MissouriMRDT/UV-Vis_Spectrometer_Hardware/UV-Vis_Spectrometer_LED_Breakout/Models/8060-2C-Step.step

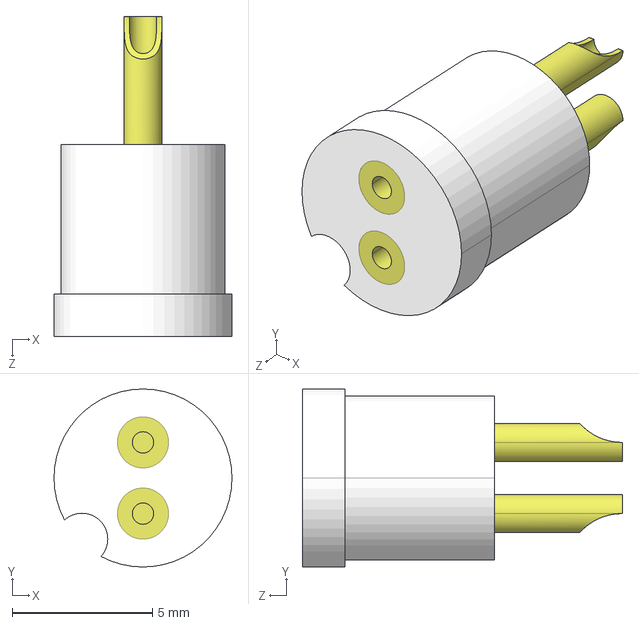
[picture p1: CAD file, 2026-11-08]
UV-Vis_Spectrometer_LED_Breakout/Models/8060-2C-Step.step
6.35 x 6.35 x 11.4 mm
