MissouriMRDT/UV-Vis_Spectrometer_Hardware/UV-Vis_Spectrometer_Photodiode_Breakout/3D Models/9007-05-00.stp

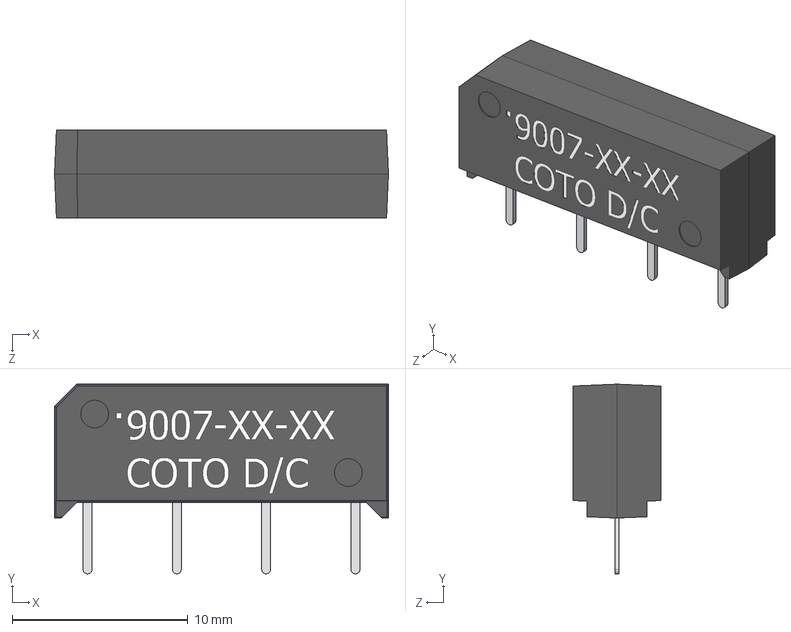
[picture p2: CAD file, 2026-11-07]
UV-Vis_Spectrometer_Photodiode_Breakout/3D Models/9007-05-00.stp
19.0 x 10.8 x 5.03 mm
