MissouriMRDT/UV-Vis_Spectrometer_Hardware/UV-Vis_Spectrometer_Photodiode_Breakout/UV-Vis_Spectrometer_Photodiode_Breakout.step

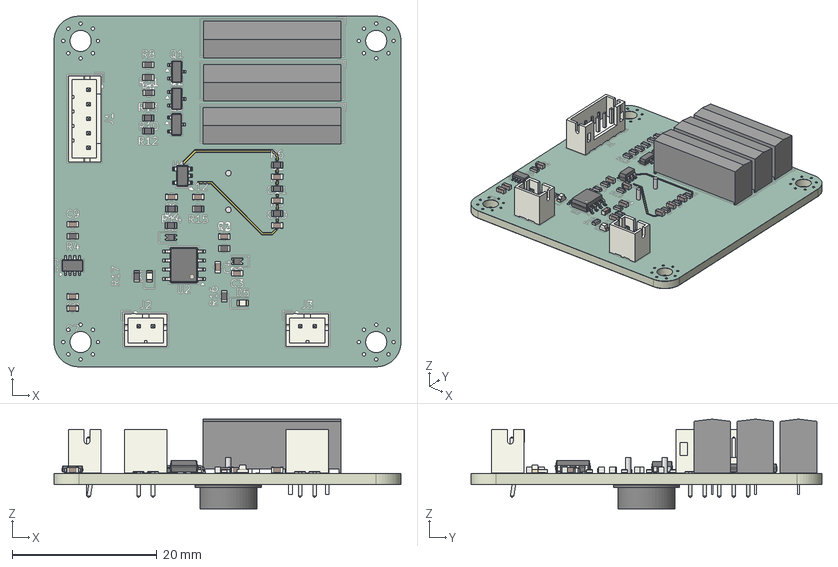
[picture p3: CAD file, 2026-11-03]
UV-Vis_Spectrometer_Photodiode_Breakout/UV-Vis_Spectrometer_Photodiode_Breakout.step
48.0 x 48.5 x 12.4 mm
D_0603 x 2
R_0603_1608Metric x 16
C_0603_1608Metric x 11
TSOT-23-8
JST_B2B_PH_K x 2
SOT-23 x 3
LED_0603_1608Metric x 2
SOT-23-5
HE3621A0510 x 3
SOIC-8_3.9x4.9mm_P1.27mm
JST_B5B_PH_K
UV-4BB8_copper
UV-4BB8_silkscreen x 2
UV-4BB8_soldermask x 2
UV-4BB8_PCB
