MissouriMRDT/UV-Vis_Spectrometer_Hardware/UV-Vis_Spectrometer_LED_Breakout/Models/LED590L-Step.step

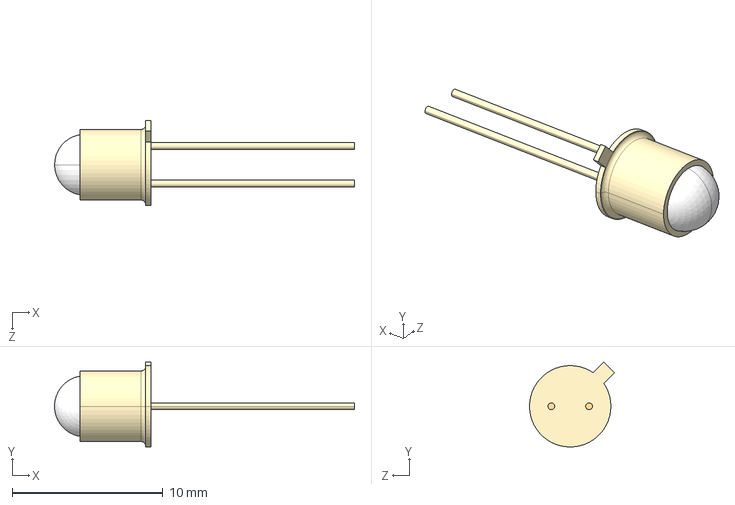
[picture p4: CAD file, 2026-11-08]
UV-Vis_Spectrometer_LED_Breakout/Models/LED590L-Step.step
19.9 x 5.64 x 5.64 mm
