MissouriMRDT/UV-Vis_Spectrometer_Hardware/UV-Vis_Spectrometer_Photodiode_Breakout/3D Models/HE3621A0510.stp

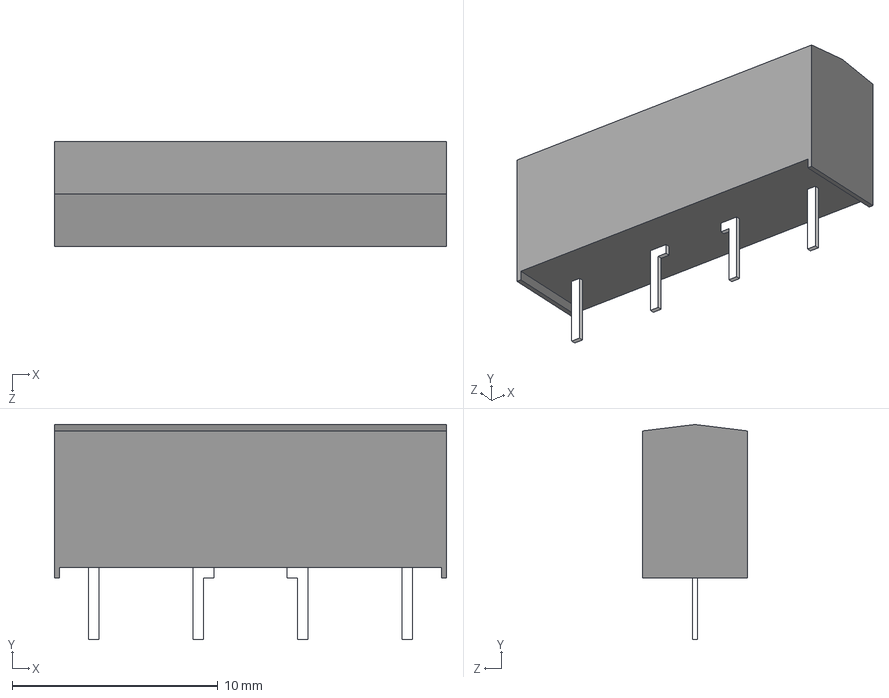
[picture p5: CAD file, 2026-11-03]
UV-Vis_Spectrometer_Photodiode_Breakout/3D Models/HE3621A0510.stp
19.1 x 10.5 x 5.08 mm
