MissouriMRDT/UV-Vis_Spectrometer_Hardware/UV-Vis_Spectrometer_Photodiode_Breakout/3D Models/TO99_BPW20RF_VIS.step

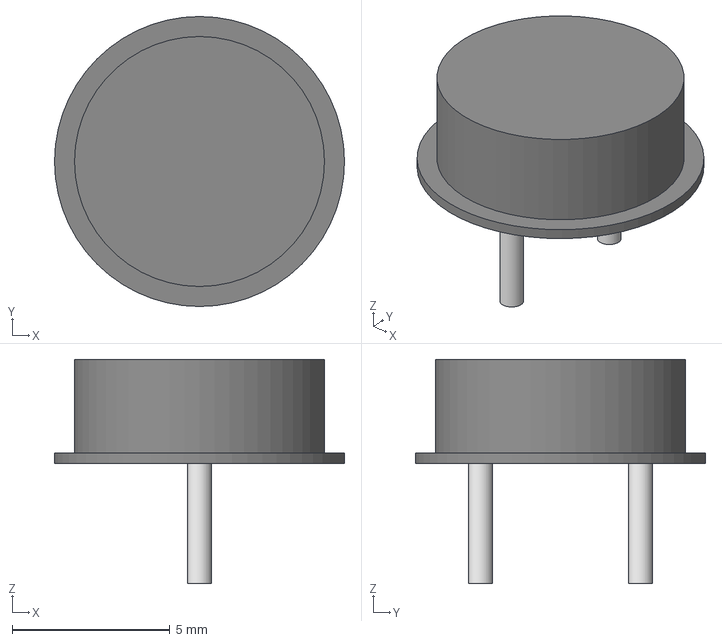
[picture p6: CAD file, 2026-11-03]
UV-Vis_Spectrometer_Photodiode_Breakout/3D Models/TO99_BPW20RF_VIS.step
9.19 x 9.19 x 7.11 mm
