MissouriMRDT/UV-Vis_Spectrometer_Hardware/UV-Vis_Spectrometer_Photodiode_Breakout/UV-Vis_Spectrometer_Photodiode_Breakout.kicad_pcb

## KiCad design UV-Vis_Spectrometer_Photodiode_Breakout/UV-Vis_Spectrometer_Photodiode_Breakout.kicad_pcb (2026-11-14)

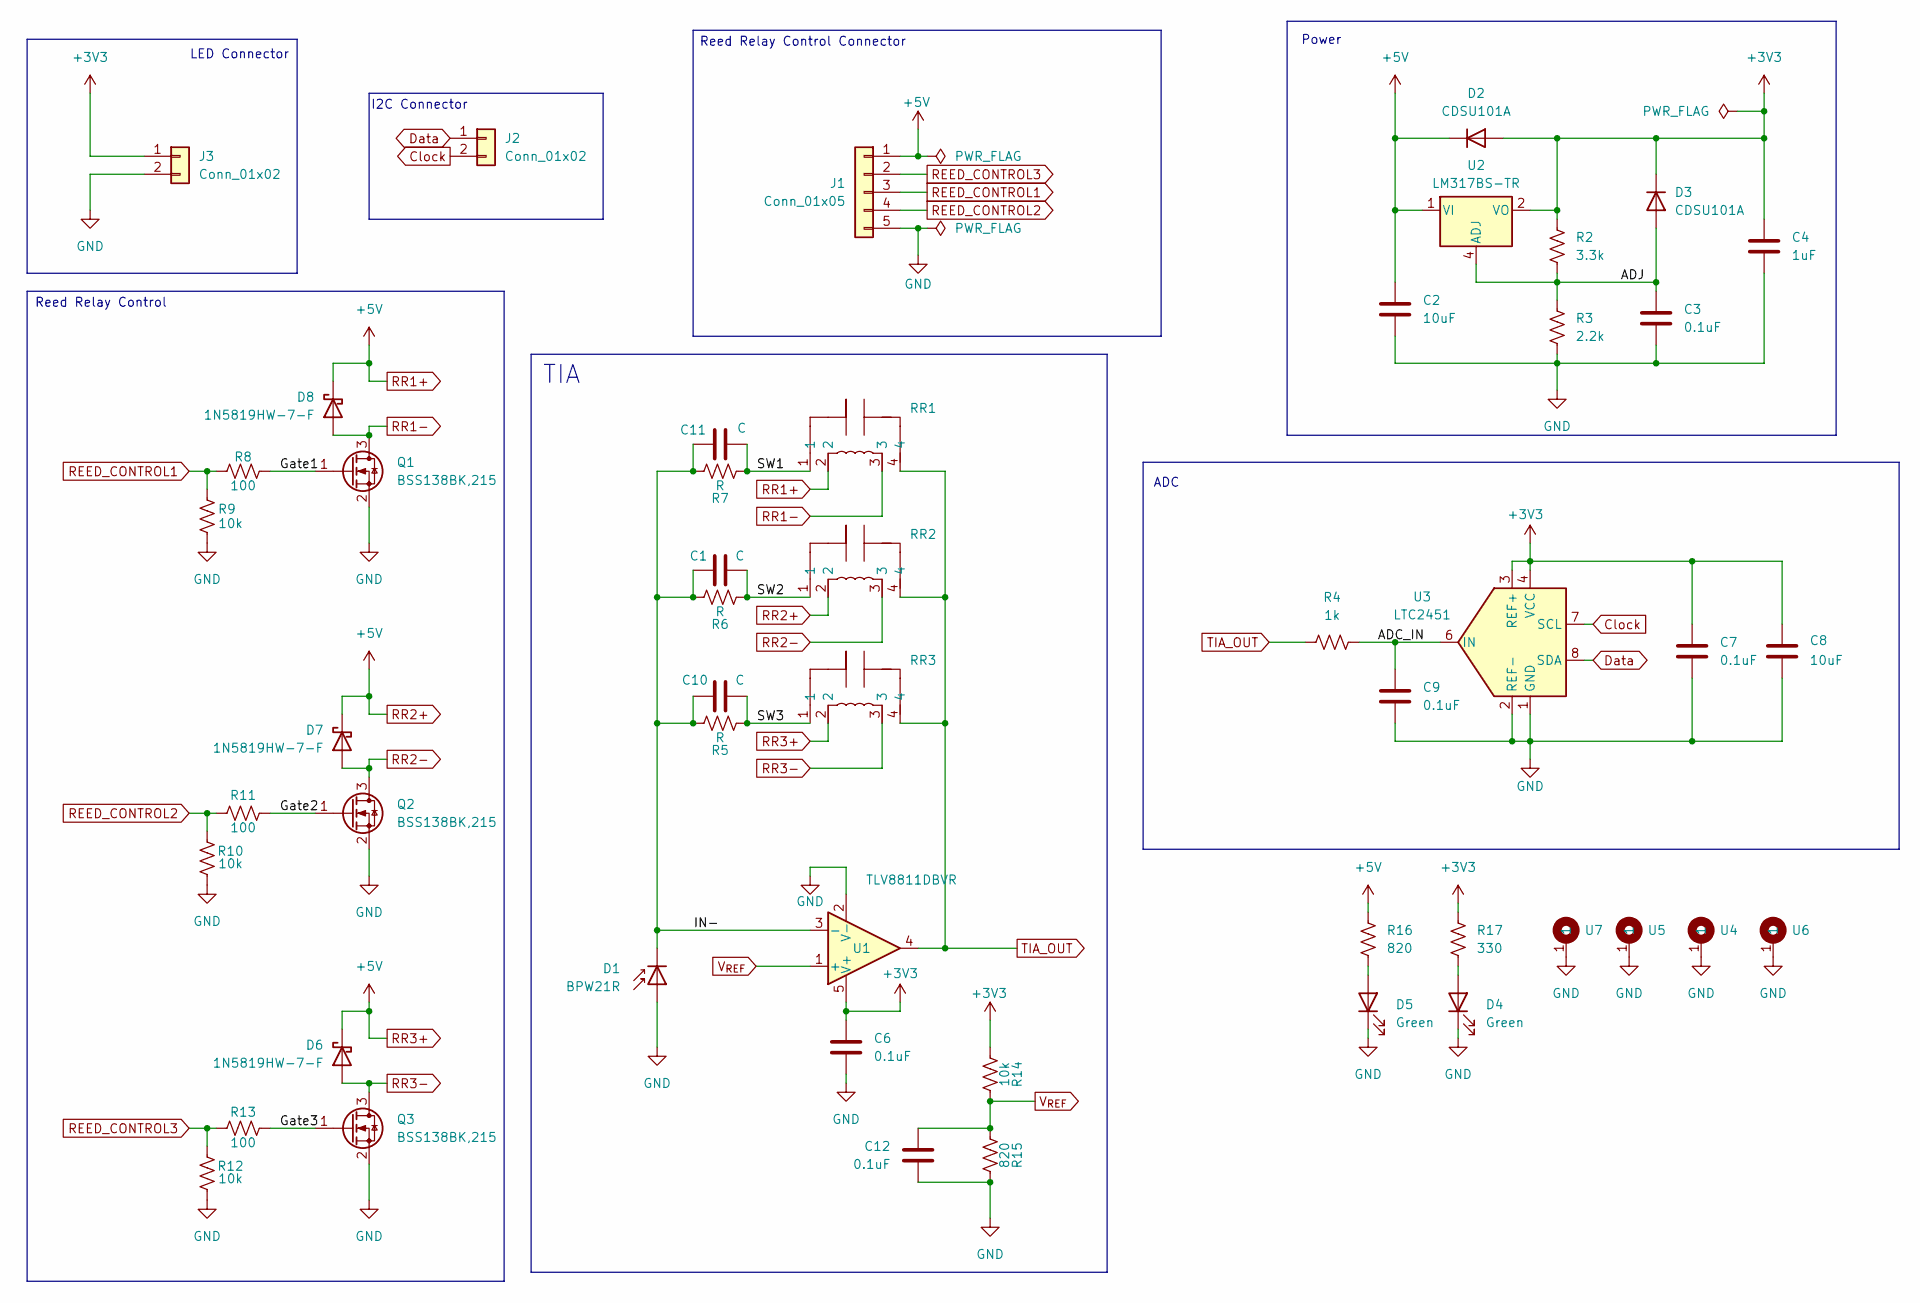
[picture p7: schematic UV-Vis_Spectrometer_Photodiode_Breakout.kicad_sch]

Parts:
C1, C10, C11: C; C_0603_1608Metric_Pad1.08x0.95mm_HandSolder
C2, C8: 10uF; C_0603_1608Metric_Pad1.08x0.95mm_HandSolder
C3, C6, C7, C9, C12: 0.1uF; C_0603_1608Metric_Pad1.08x0.95mm_HandSolder
C4: 1uF; C_0603_1608Metric_Pad1.08x0.95mm_HandSolder
D1: BPW21R
D2, D3: CDSU101A; D_0603_1608Metric_Pad1.05x0.95mm_HandSolder
D4, D5: Green; LED_0603_1608Metric_Pad1.05x0.95mm_HandSolder
D6, D7, D8: 1N5819HW-7-F; D_SOD-123
J1: Conn_01x05; JST_PH_S5B-PH-K_1x05_P2.00mm_Horizontal
J2, J3: Conn_01x02; JST_PH_S2B-PH-K_1x02_P2.00mm_Horizontal
Q1, Q2, Q3: BSS138BK,215; SOT-23
R2: 3.3k; R_0603_1608Metric_Pad0.98x0.95mm_HandSolder
R3: 2.2k; R_0603_1608Metric_Pad0.98x0.95mm_HandSolder
R4: 1k; R_0603_1608Metric_Pad0.98x0.95mm_HandSolder
R5, R6, R7: R; R_0603_1608Metric_Pad0.98x0.95mm_HandSolder
R8, R11, R13: 100; R_0603_1608Metric_Pad0.98x0.95mm_HandSolder
R9, R10, R12, R14: 10k; R_0603_1608Metric_Pad0.98x0.95mm_HandSolder
R15, R16: 820; R_0603_1608Metric_Pad0.98x0.95mm_HandSolder
R17: 330; R_0603_1608Metric_Pad0.98x0.95mm_HandSolder
RR1, RR2, RR3: Relay_SPDT_9007_05_00
U1: TLV8811DBVR; SOT-23-5_HandSoldering
U2: LM317BS-TR; SOIC-8_3.9x4.9mm_P1.27mm
U3: LTC2451; TSOT-23-8
U4, U5, U6, U7: 4_40_Hole_Pad_Via

Connections:
+3V3: C4.1, C6.2, C7.1, C8.1, D2.2 (A), D3.1 (K), J3.1, R2.1, R14.2, R17.1, U1.5 (V+), U2.2 (VO), U2.3 (VO), U2.6 (VO), U2.7 (VO), U3.3 (REF+), U3.4 (VCC)
/ADC_IN: C9.1, R4.2, U3.6 (IN)
/ADJ: C3.1, D3.2 (A), R2.2, R3.1, U2.4 (ADJ)
/Gate1: Q1.1 (G), R8.2
/Gate2: Q2.1 (G), R11.2
/Gate3: Q3.1 (G), R13.2
/IN-: C1.1, C10.1, C11.1, D1.1 (K), R5.1, R6.1, R7.1, U1.3 (-)
/SW1: C11.2, R7.2, RR1.1
/SW2: C1.2, R6.2, RR2.1
/SW3: C10.2, R5.2, RR3.1
Clock: J2.2, U3.7 (SCL)
Data: J2.1, U3.8 (SDA)
GND: C2.2, C3.2, C4.2, C6.1, C7.2, C8.2, C9.2, C12.2, D1.2 (A), D4.1 (K), D5.1 (K), J1.5, J3.2, Q1.2 (S), Q2.2 (S), Q3.2 (S), R3.2, R9.1, R10.1, R12.1, R15.1, U1.2 (V-), U3.1 (GND), U3.2 (REF-), U3.5 (GND), U4.1 (1_1), U5.1 (1_1), U6.1 (1_1), U7.1 (1_1)
unnamed: D4.2 (A), R17.2
unnamed: D5.2 (A), R16.2
REED_CONTROL1: J1.3, R8.1, R9.2
REED_CONTROL2: J1.4, R10.2, R11.1
REED_CONTROL3: J1.2, R12.2, R13.1
RR1+: C2.1, D2.1 (K), D6.1 (K), D7.1 (K), D8.1 (K), J1.1, R16.1, RR1.2, RR2.2, RR3.2, U2.1 (VI)
RR1-: D8.2 (A), Q1.3 (D), RR1.3
RR2-: D7.2 (A), Q2.3 (D), RR2.3
RR3-: D6.2 (A), Q3.3 (D), RR3.3
TIA_OUT: R4.1, RR1.4, RR2.4, RR3.4, U1.4
V_{REF}: C12.1, R14.1, R15.2, U1.1 (+)

Notes on the sheet:
I2C Connector
Reed Relay Control
ADC
Reed Relay Control Connector
LED Connector
Power
TIA

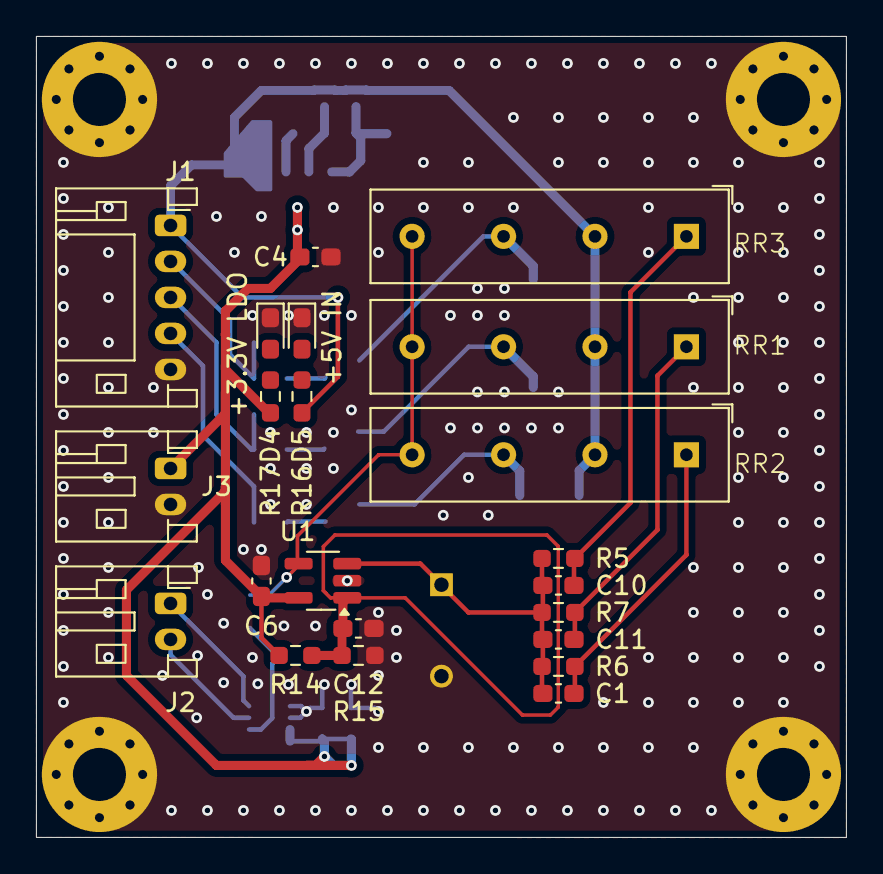
[picture p8: board UV-Vis_Spectrometer_Photodiode_Breakout.kicad_pcb from above]

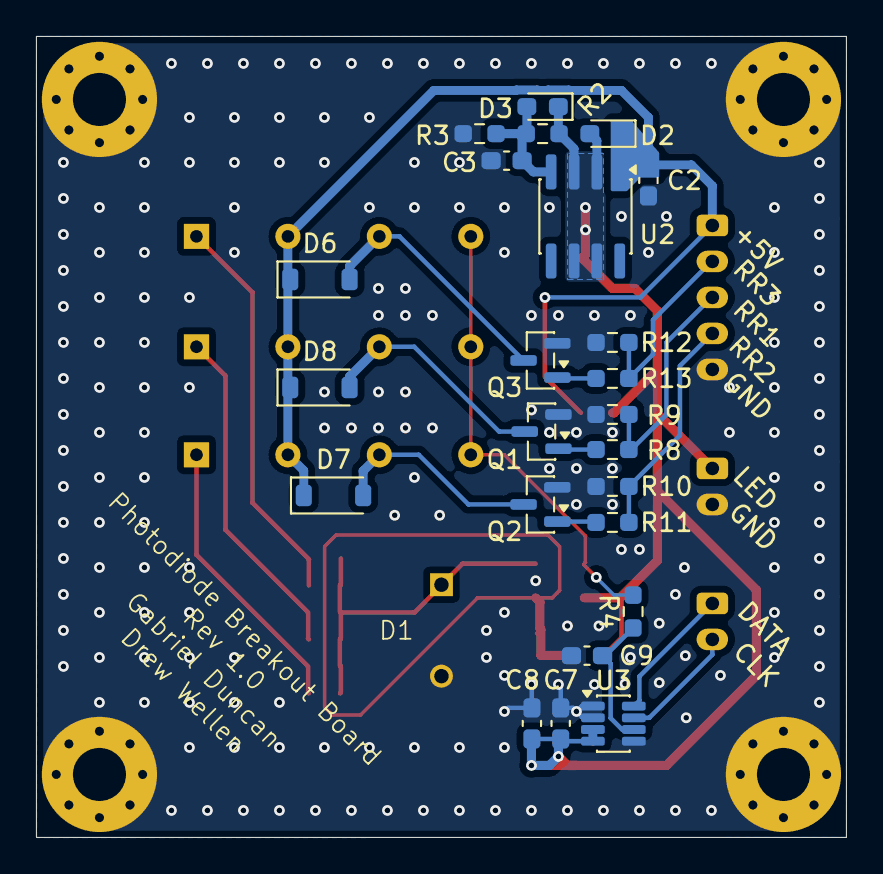
[picture p9: board UV-Vis_Spectrometer_Photodiode_Breakout.kicad_pcb from below]

Board: 2 copper layers, 45.0 x 44.5 mm, 51 parts (25 on the bottom side), 24 nets.
