MissouriMRDT/UV-Vis_Spectrometer_Hardware/UV-Vis_Spectrometer_LED_Breakout/UV-Vis_Spectrometer_LED_Breakout.kicad_pcb

## KiCad design UV-Vis_Spectrometer_LED_Breakout/UV-Vis_Spectrometer_LED_Breakout.kicad_pcb (2026-11-09)

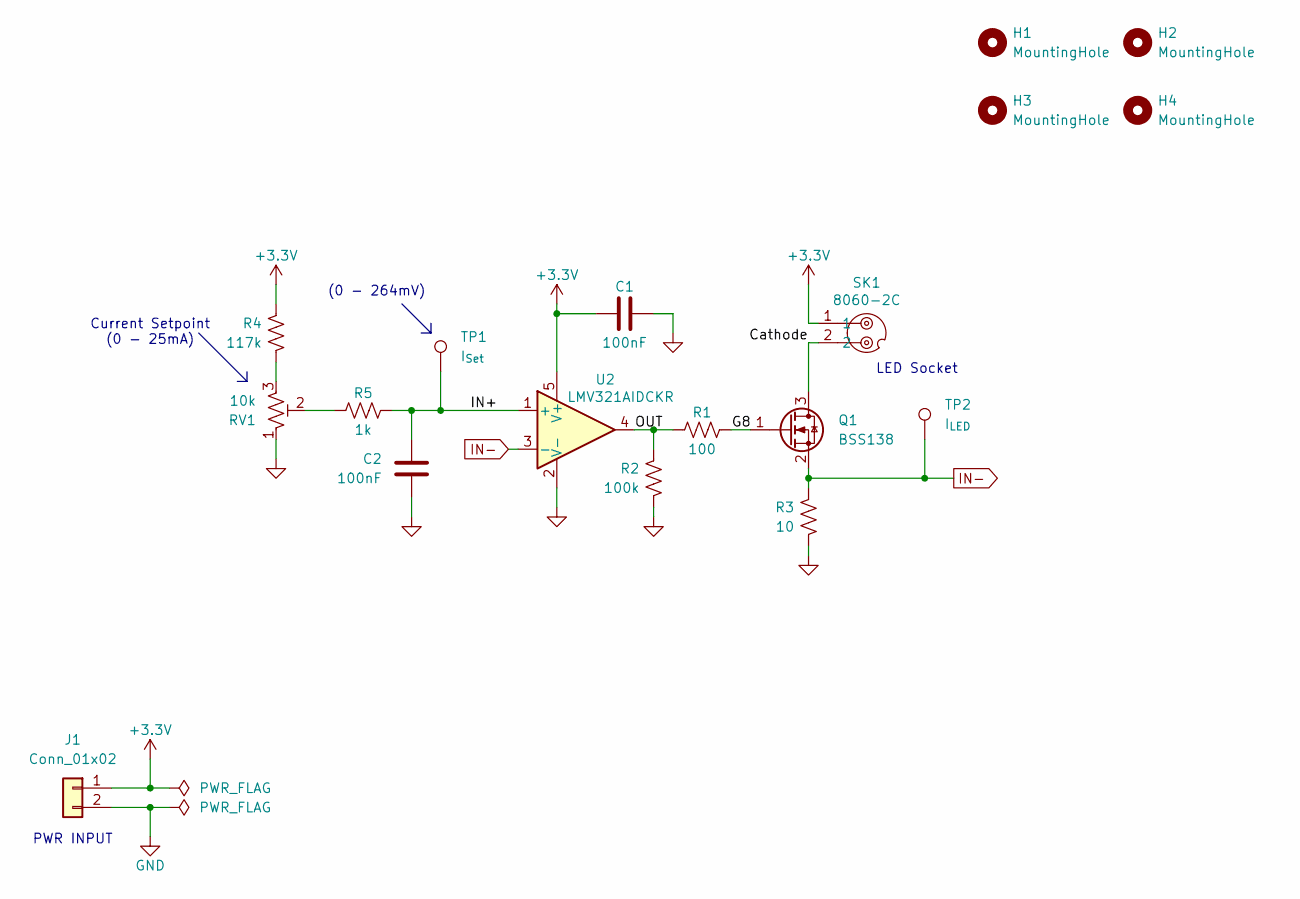
[picture p10: schematic UV-Vis_Spectrometer_LED_Breakout.kicad_sch]

Parts:
C1, C2: 100nF; C_0603_1608Metric
H1, H2, H3, H4: MountingHole; 4_40_Hole_Pad_Via
J1: Conn_01x02; JST_EH_B2B-EH-A_1x02_P2.50mm_Vertical
Q1: BSS138; SOT-23
R1: 100; R_0603_1608Metric
R2: 100k; R_0603_1608Metric
R3: 10; R_0603_1608Metric
R4: 117k; R_0603_1608Metric
R5: 1k; R_0603_1608Metric
RV1: 10k; Potentiometer_Bourns_3296W_Vertical
SK1: 8060-2C
TP1: I_{Set}; TestPoint_Pad_D1.5mm
TP2: I_{LED}; TestPoint_Pad_D1.5mm
U2: LMV321AIDCKR; SOT-353_SC-70-5

Connections:
+3.3V: C1.1, J1.1, R4.2, SK1.1, U2.5 (V+)
CS/FB: Q1.2 (S), R3.2, TP2.1 (1_1), U2.3 (-)
GND: C1.2, C2.2, J1.2, R2.1, R3.1, RV1.1, U2.2 (V-)
unnamed: Q1.3 (D), SK1.2
unnamed: Q1.1 (G), R1.2
unnamed: R1.1, R2.2, U2.4
unnamed: R4.1, RV1.3
unnamed: R5.1, RV1.2
unnamed: C2.1, R5.2, TP1.1 (1_1), U2.1 (+)

Notes on the sheet:
Current Setpoint (0 - 25mA)
PWR INPUT
LED Socket
(0 - 264mV)

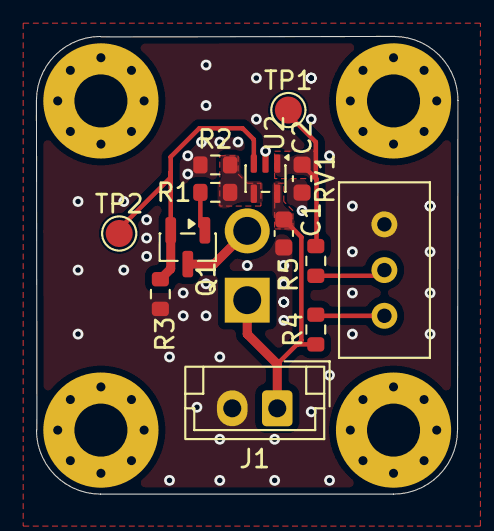
[picture p11: board UV-Vis_Spectrometer_LED_Breakout.kicad_pcb from above]

Board: 2 copper layers, 23.4 x 25.4 mm, 18 parts (1 on the bottom side), 9 nets.
