MissouriMRDT/UV-Vis_Spectrometer_Hardware/(commit log)

2026-09-16 Project Initialization
    [UV-Vis_Spectrometer_LED_Breakout.kicad_pcb, UV-Vis_Spectrometer_LED_Breakout.kicad_sch, UV-Vis_Spectrometer_Photodiode_Breakout.kicad_pcb, UV-Vis_Spectrometer_Photodiode_Breakout.kicad_sch]
2026-10-13 UV-Vis Photometer Circuit Diagram
    [UV-Vis_Spectrometer_Photodiode_Breakout.kicad_sch, untitled.kicad_sch]
2026-10-15 added reed switches, res values needed
    [UV-Vis_Spectrometer_Photodiode_Breakout.kicad_sch]
2026-10-16 Designed adjustable LED current source
    [UV-Vis_Spectrometer_LED_Breakout.kicad_sch]
2026-10-16 Added datasheet to LED socket symbol
    [UV-Vis_Spectrometer_LED_Breakout.kicad_sch]
2026-10-16 Added Connectors and Resistance values for the TIA
    [UV-Vis_Spectrometer_Photodiode_Breakout.kicad_sch]
2026-10-17 Cleaned up op amp circuit. Added Vref. Made reed relay symbol.
    [UV-Vis_Spectrometer_Photodiode_Breakout.kicad_sch, untitled.kicad_sch]
2026-10-17 Made some nice boxes and labels.
    [UV-Vis_Spectrometer_Photodiode_Breakout.kicad_sch]
2026-10-20 Added LED shunt testpoint
    [UV-Vis_Spectrometer_LED_Breakout.kicad_sch]
2026-10-20 Added footprints and started layouts.
    [UV-Vis_Spectrometer_Photodiode_Breakout.kicad_pcb, UV-Vis_Spectrometer_Photodiode_Breakout.kicad_sch]
2026-10-23 Made footprint for photodiode. Made basic layout for PCB.
    [Telegrapher's Circuit Model.kicad_pcb, Telegrapher's Circuit Model.kicad_sch, UV-Vis_Spectrometer_Photodiode_Breakout.kicad_pcb, UV-Vis_Spectrometer_Photodiode_Breakout.kicad_sch]
2026-10-29 Attempted to make layout smaller.
    [UV-Vis_Spectrometer_Photodiode_Breakout.kicad_pcb, UV-Vis_Spectrometer_Photodiode_Breakout.kicad_sch]
2026-10-29 Moved the layout around a bit.
    [UV-Vis_Spectrometer_Photodiode_Breakout.kicad_pcb, UV-Vis_Spectrometer_Photodiode_Breakout.kicad_sch]
2026-10-29 Updated footprint for Reed Relays.
    [UV-Vis_Spectrometer_Photodiode_Breakout.kicad_pcb, UV-Vis_Spectrometer_Photodiode_Breakout.kicad_sch]
2026-10-29 Added guard trace.
    [UV-Vis_Spectrometer_Photodiode_Breakout.kicad_pcb, UV-Vis_Spectrometer_Photodiode_Breakout.kicad_sch]
2026-10-30 General layout of components clean. Board is dimensioned.
    [UV-Vis_Spectrometer_Photodiode_Breakout.kicad_pcb]
2026-10-31 Made layout for LED driver.
    [UV-Vis_Spectrometer_LED_Breakout.kicad_pcb, UV-Vis_Spectrometer_LED_Breakout.kicad_sch]
2026-10-31 fixed mounting holes
    [UV-Vis_Spectrometer_LED_Breakout.kicad_pcb, UV-Vis_Spectrometer_LED_Breakout.kicad_sch]
2026-10-31 cleaned up text for dimensions.
    [UV-Vis_Spectrometer_Photodiode_Breakout.kicad_pcb]
2026-11-01 cleaned the dimensions of the board.
    [UV-Vis_Spectrometer_LED_Breakout.kicad_pcb]
2026-11-03 Add 3D model files & swap to vertical connectors
    [HE3621A0510.stp, TO99_BPW20RF_VIS.step, UV-Vis_Spectrometer_Photodiode_Breakout.kicad_pcb, UV-Vis_Spectrometer_Photodiode_Breakout.kicad_sch, UV-Vis_Spectrometer_Photodiode_Breakout.step]
2026-11-05 Made traces for UV-Board.
    [UV-Vis_Spectrometer_Photodiode_Breakout.kicad_pcb, UV-Vis_Spectrometer_Photodiode_Breakout.kicad_sch]
2026-11-05 Made trace for output of TIA. Connected all the ground pins.
    [UV-Vis_Spectrometer_Photodiode_Breakout.kicad_pcb]
2026-11-07 Full board design
    [UV-Vis_Spectrometer_Photodiode_Breakout.kicad_pcb, UV-Vis_Spectrometer_Photodiode_Breakout.kicad_sch]
2026-11-07 Final Touches
    [9007-05-00.stp, UV-Vis_Spectrometer_Photodiode_Breakout.kicad_pcb]
2026-11-07 Changed solder mask colour
2026-11-07 Added photodiode 3D model
    [UV-Vis_Spectrometer_Photodiode_Breakout.kicad_pcb]
2026-11-08 led board
    [8060-2C-Step.step, LED590L-Step.step, UV-Vis_Spectrometer_LED_Breakout.kicad_pcb, UV-Vis_Spectrometer_LED_Breakout.kicad_sch]
2026-11-08 Resolved DRC and centered LED
    [UV-Vis_Spectrometer_LED_Breakout.kicad_pcb, UV-Vis_Spectrometer_LED_Breakout.kicad_sch]
2026-11-08 3D models
    [UV-Vis_Spectrometer_LED_Breakout.kicad_pcb]
2026-11-09 fixing deminsions and zones
    [UV-Vis_Spectrometer_LED_Breakout.kicad_pcb]
2026-11-14 Added no mask zone around GND pin
    [UV-Vis_Spectrometer_Photodiode_Breakout.kicad_pcb]
